janyman/diplomat-modbus/hw/diplomat-modbus_rev_a.pdf

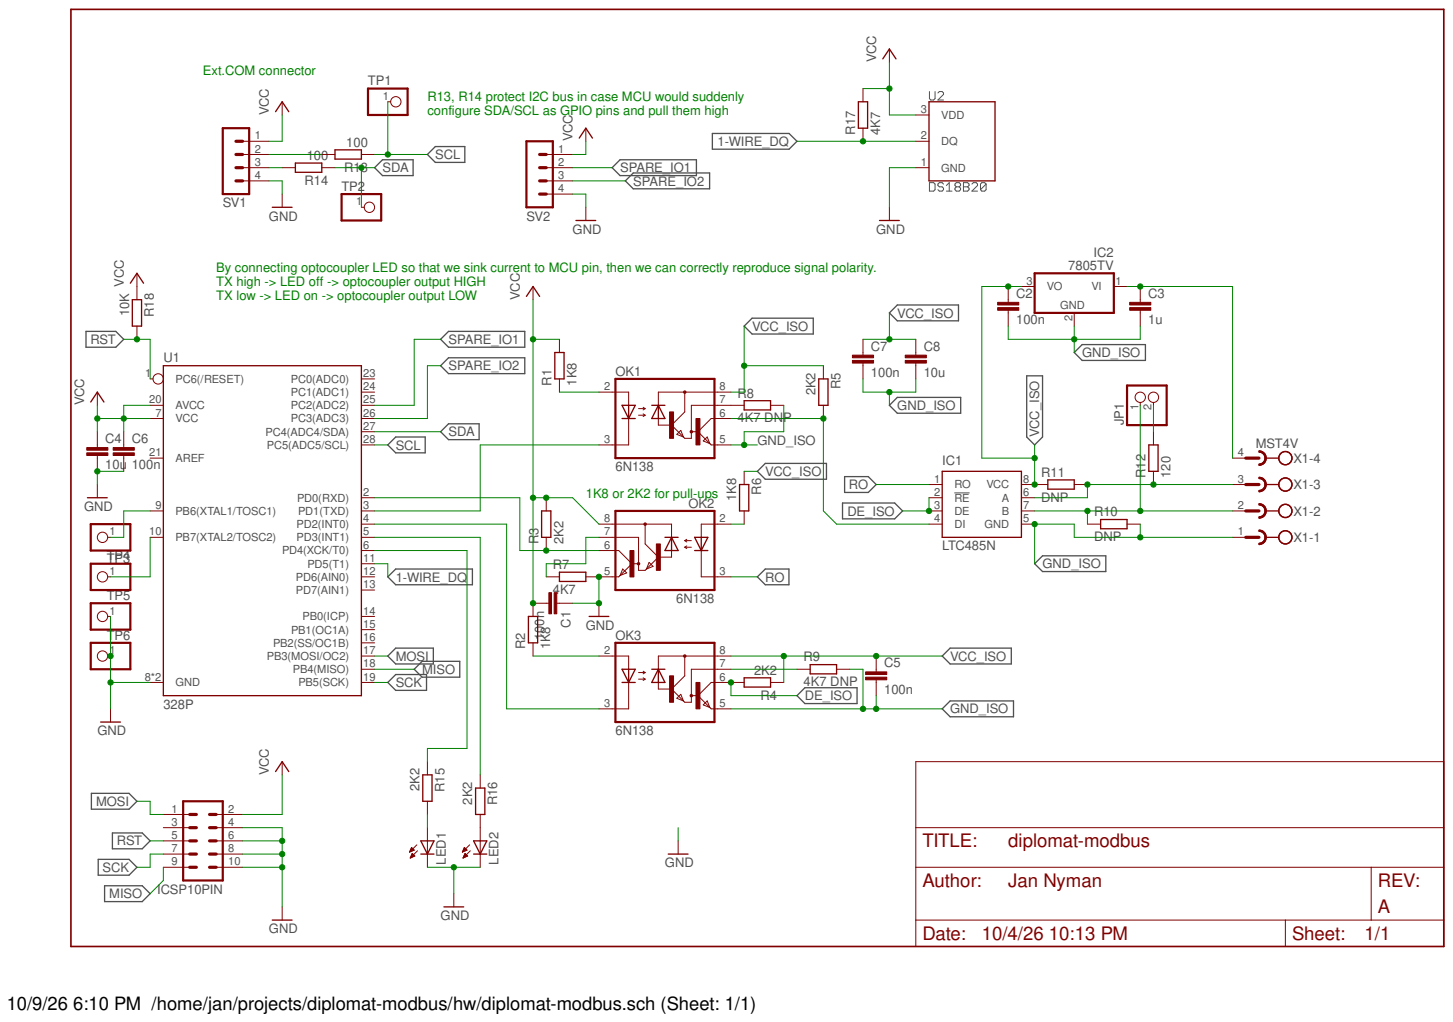
[picture p2: page 1]

configure SDA/SCL as GPIO pins and pull them high

By connecting optocoupler LED so that we sink current to MCU pin, then we can correctly reproduce signal polarity. TX high -> LED off -> optocoupler output HIGH

TX low -> LED on -> optocoupler output LOW

1K8 or 2K2 for pull-ups

Author: Jan Nyman | REV: A

Date: 10/4/26 10:13 PM | Sheet: 1/1

10/9/26 6:10 PM /home/jan/projects/diplomat-modbus/hw/diplomat-modbus.sch (Sheet: 1/1)
