janyman/diplomat-modbus/hw/diplomat-modbus.brd

## EAGLE design hw/diplomat-modbus.brd (2026-10-04)

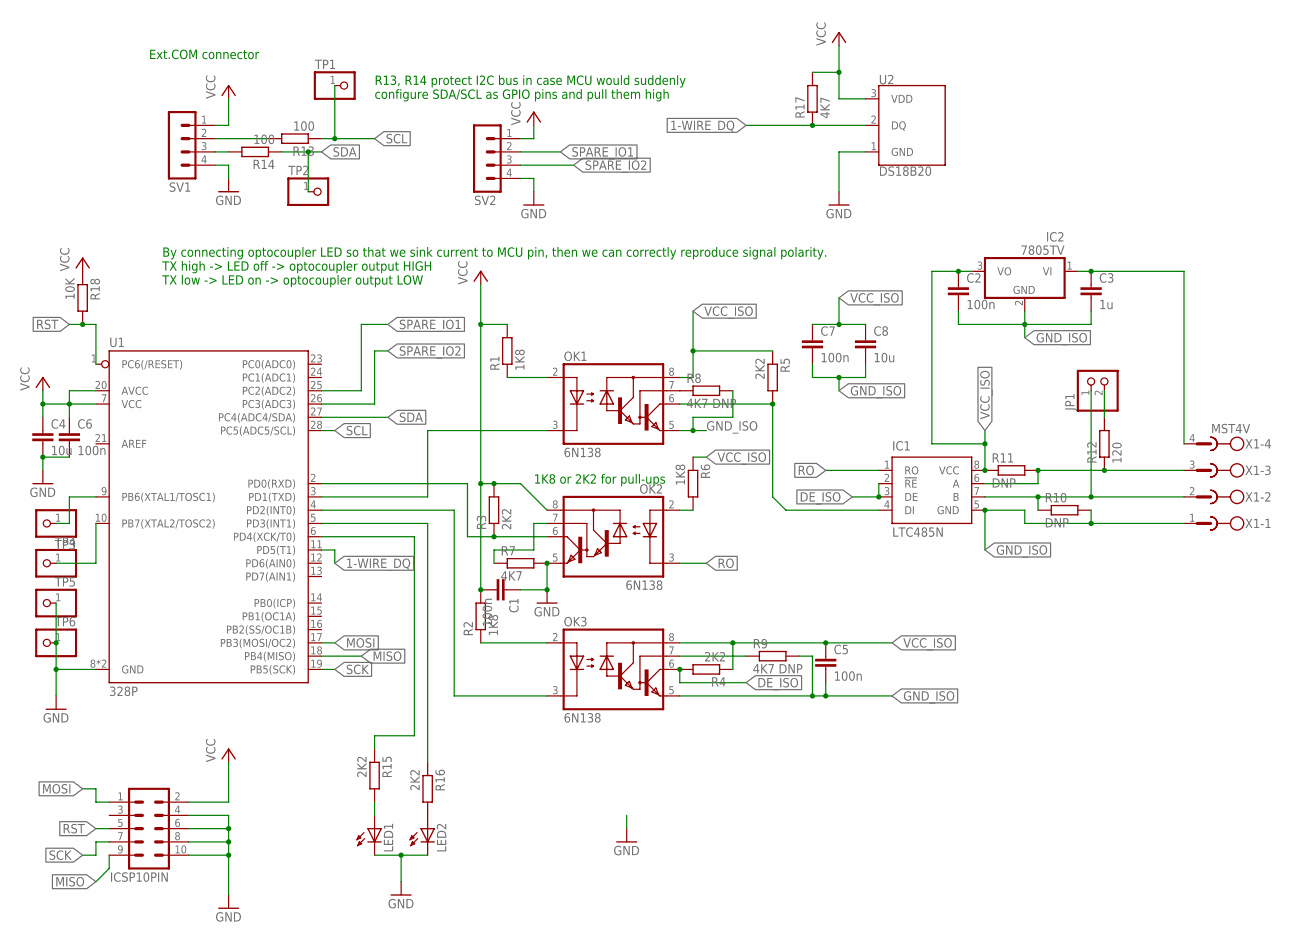
[picture p3: schematic diplomat-modbus.sch]

Parts:
C1, C2, C5, C6, C7: 100n; C025-024X044
C3: 1u; C025-024X044
C4, C8: 10u; C025-024X044
IC1: LTC485N; DIL08
IC2: 7805TV; TO220V
ICSP10PIN: MA05-2
JP1: PINHD-1X2; 1X02
LED1, LED2: LED3MM
OK1, OK2, OK3: 6N138; DIL08
R1, R2, R6: 1K8; 0309V
R3, R4, R5, R15, R16: 2K2; 0309V
R7, R17: 4K7; 0309V
R8, R9: 4K7 DNP; 0309V
R10, R11: DNP; 0309V
R12: 120; 0309V
R13, R14: 100; 0309V
R18: 10K; 0309V
SV1, SV2: MA04-1
TP1, TP2, TP3, TP4, TP5, TP6: PINHD-1X1; 1X01
U1: 328P; DIP28
U2: DS18B20; TO-92-AMMO
X1: MST4V; MSTBV4

Connections:
1-WIRE_DQ: R17.1, U1.11 (PD5(T1)), U2.2 (DQ)
DE_ISO: IC1.2 (!RE), IC1.3 (DE), OK3.6 (VO), R4.2
GND: C1.1, C4.2, C6.2, ICSP10PIN.4, ICSP10PIN.6, ICSP10PIN.8, ICSP10PIN.10, LED1.K (C), LED2.K (C), OK2.5 (GND), R7.2, SV1.4, SV2.4, TP5.1, TP6.1, U1.8 (GND), U1.22 (GND), U2.1 (GND)
GND_ISO: C2.2, C3.2, C5.2, C7.2, C8.2, IC1.5 (GND), IC2.2 (GND), OK1.5 (GND), OK3.5 (GND), R8.2, R9.2, R10.2, X1.1
MISO: ICSP10PIN.9, U1.18 (PB4(MISO))
MOSI: ICSP10PIN.1, U1.17 (PB3(MOSI/OC2))
unnamed: OK1.3 (C), U1.3 (PD1(TXD))
unnamed: OK1.2 (A), R1.1
unnamed: OK3.2 (A), R2.1
unnamed: OK3.3 (C), U1.4 (PD2(INT0))
unnamed: JP1.2, R12.2
unnamed: IC1.4 (DI), OK1.6 (VO), R5.2
unnamed: TP3.1, U1.9 (PB6(XTAL1/TOSC1))
unnamed: OK2.2 (A), R6.2
unnamed: IC1.7 (B), JP1.1, R10.1, X1.2
unnamed: IC1.6 (A), R11.2, R12.1, X1.3
unnamed: C3.1, IC2.1 (VI), X1.4
unnamed: OK2.7 (VB), R7.1
unnamed: OK1.7 (VB), R8.1
unnamed: R13.2, SV1.2
unnamed: OK3.7 (VB), R9.1
unnamed: R15.1, U1.6 (PD4(XCK/T0))
unnamed: R16.1, U1.5 (PD3(INT1))
unnamed: LED1.A, R15.2
unnamed: LED2.A, R16.2
unnamed: TP4.1, U1.10 (PB7(XTAL2/TOSC2))
RO: IC1.1 (RO), OK2.3 (C)
RST: ICSP10PIN.5, R18.2, U1.1 (PC6(/RESET))
RX: OK2.6 (VO), R3.1, U1.2 (PD0(RXD))
SCK: ICSP10PIN.7, U1.19 (PB5(SCK))
SCL: R13.1, TP1.1, U1.28 (PC5(ADC5/SCL))
SDA: R14.1, TP2.1, U1.27 (PC4(ADC4/SDA))
SPARE_IO1: SV2.2, U1.25 (PC2(ADC2))
SPARE_IO2: SV2.3, U1.26 (PC3(ADC3))
VCC: C1.2, C4.1, C6.1, ICSP10PIN.2, OK2.8 (VCC), R1.2, R2.2, R3.2, R17.2, R18.1, SV1.1, SV2.1, U1.7 (VCC), U1.20 (AVCC), U2.3 (VDD)
VCC_ISO: C2.1, C5.1, C7.1, C8.1, IC1.8 (VCC), IC2.3 (VO), OK1.8 (VCC), OK3.8 (VCC), R4.1, R5.1, R6.1, R11.1
XXX: R14.2, SV1.3

Notes on the sheet:
By connecting optocoupler LED so that we sink current to MCU pin, then we can correctly reproduce signal polarity. TX high -> LED off -> optocoupler output HIGH TX low -> LED on -> optocoupler output LOW
1K8 or 2K2 for pull-ups
Ext.COM connector
R13, R14 protect I2C bus in case MCU would suddenly configure SDA/SCL as GPIO pins and pull them high

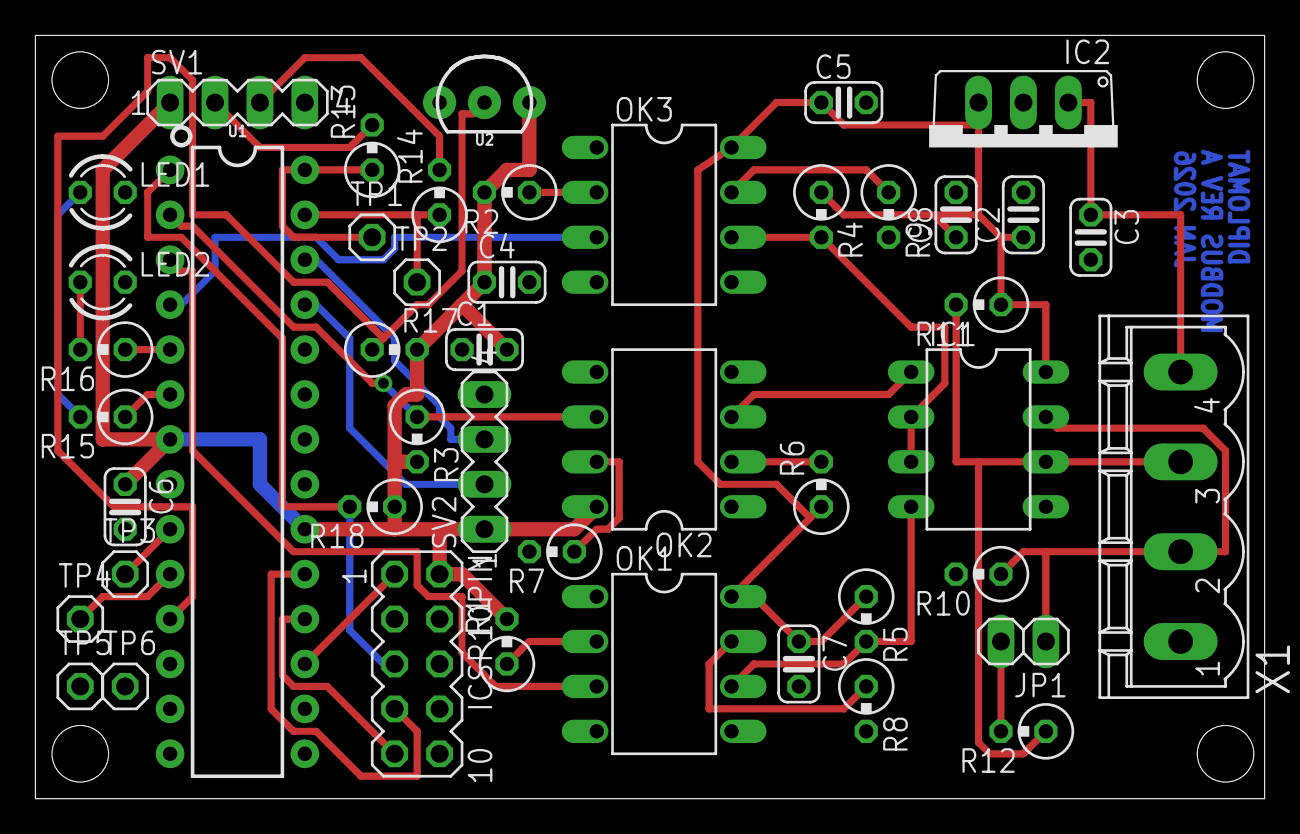
[picture p4: board diplomat-modbus.brd from above]

Board: 2 copper layers, 69.5 x 43.2 mm, 46 parts (0 on the bottom side), 37 nets.
