janyman/diplomat-modbus/src/mbport/port.h

/*
 * FreeModbus Libary: AVR Port
 * Copyright (C) 2006 Christian Walter <wolti@sil.at>
 *   - Initial version + ATmega168 support
 * Modfications Copyright (C) 2006 Tran Minh Hoang:
 *   - ATmega8, ATmega16, ATmega32 support
 *   - RS485 support for DS75176
 *
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
 * File: $Id$
 */

#ifndef _PORT_H
#define _PORT_H

/* ----------------------- Platform includes --------------------------------*/

#include <avr/io.h>
#include <avr/interrupt.h>

/* ----------------------- Defines ------------------------------------------*/
#define	INLINE                      inline
#define PR_BEGIN_EXTERN_C           extern "C" {
#define	PR_END_EXTERN_C             }

#define ENTER_CRITICAL_SECTION( )   cli()
#define EXIT_CRITICAL_SECTION( )    sei()

#define assert( x )

typedef char    BOOL;

typedef unsigned char UCHAR;
typedef char    CHAR;

typedef unsigned short USHORT;
typedef short   SHORT;

typedef unsigned long ULONG;
typedef long    LONG;

#ifndef TRUE
#define TRUE            1
#endif

#ifndef FALSE
#define FALSE           0
#endif

/* ----------------------- AVR platform specifics ---------------------------*/

#if defined (__AVR_ATmega168__) || defined (__AVR_ATmega328P__)
#define UCSRB           UCSR0B
#define TXEN            TXEN0
#define RXEN            RXEN0
#define RXCIE           RXCIE0
#define TXCIE           TXCIE0
#define UDRE            UDRE0
#define UBRR            UBRR0
#define UCSRC           UCSR0C
#define UPM1            UPM01
#define UPM0            UPM00
#define UCSZ0           UCSZ00
#define UCSZ1           UCSZ01
#define UDR             UDR0
#define SIG_UART_TRANS  SIG_USART_TRANS

#elif defined (__AVR_ATmega169__)

#define SIG_UART_TRANS  SIG_USART_TRANS

#elif defined (__AVR_ATmega8__)
#define UBRR            UBRRL
#define TCCR1C          TCCR1A  /* dummy */
#define TIMSK1          TIMSK
#define TIFR1           TIFR
#define SIG_USART_DATA  SIG_UART_DATA
#define SIG_USART_RECV  SIG_UART_RECV

#elif defined (__AVR_ATmega16__)
#define UBRR            UBRRL
#define TCCR1C          TCCR1A  /* dummy */
#define TIMSK1          TIMSK
#define TIFR1           TIFR

#elif defined (__AVR_ATmega32__)
#define UBRR            UBRRL
#define TCCR1C          TCCR1A  /* dummy */
#define TIMSK1          TIMSK
#define TIFR1           TIFR

#elif defined (__AVR_ATmega128__)
#define UCSRB           UCSR0B
#define UBRR            UBRR0L
#define UDR             UDR0
#define TIMSK1          TIMSK
#define TIFR1           TIFR
#define SIG_UART_TRANS  SIG_USART0_TRANS
#define SIG_USART_DATA  SIG_USART0_DATA
#define SIG_USART_RECV  SIG_USART0_RECV
#define UCSZ0           UCSZ00
#define UCSZ1           UCSZ01
#define UPM0            UPM00
#define UPM1            UPM01
#define UCSRC           UCSR0C

#endif

/* ----------------------- RS485 specifics ----------------------------------*/
#ifdef  RTS_ENABLE


#define RTS_PIN         PD2
#define RTS_DDR         DDRD
#define RTS_PORT        PORTD

#define RTS_INIT        \
    do { \
        RTS_DDR |= _BV( RTS_PIN ); \
        RTS_PORT &= ~( _BV( RTS_PIN ) ); \
    } while( 0 );

#define RTS_HIGH        \
    do { \
        RTS_PORT |= _BV( RTS_PIN ); \
    } while( 0 );

#define RTS_LOW         \
    do { \
        RTS_PORT &= ~( _BV( RTS_PIN ) ); \
    } while( 0 );

#endif

#endif
