janyman/diplomat-modbus/(commit log)

2026-09-07 Add subrepo avr-i2c-slave
2026-09-25 Added empirically obtained information about Ext.COM +5V rail
2026-10-09 pdf schematics
2026-10-10 Firmware ported to custom 'diplomat modbus' board
2026-10-22 Extended list of registers, and more robust i2c handling
2026-10-25 Point to my fork of avr-i2c-slave
